anabrid/TeensyLogger/prototype_1.jpg

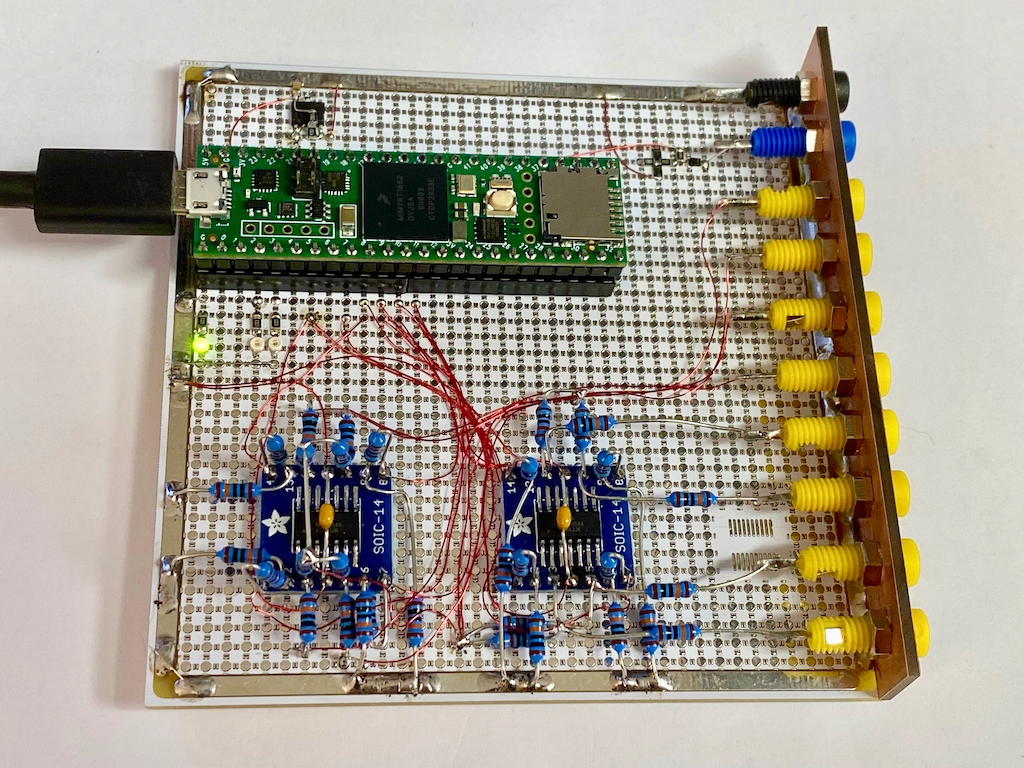
prototype_1.jpg
