anabrid/TeensyLogger/TeensyLogger.pdf

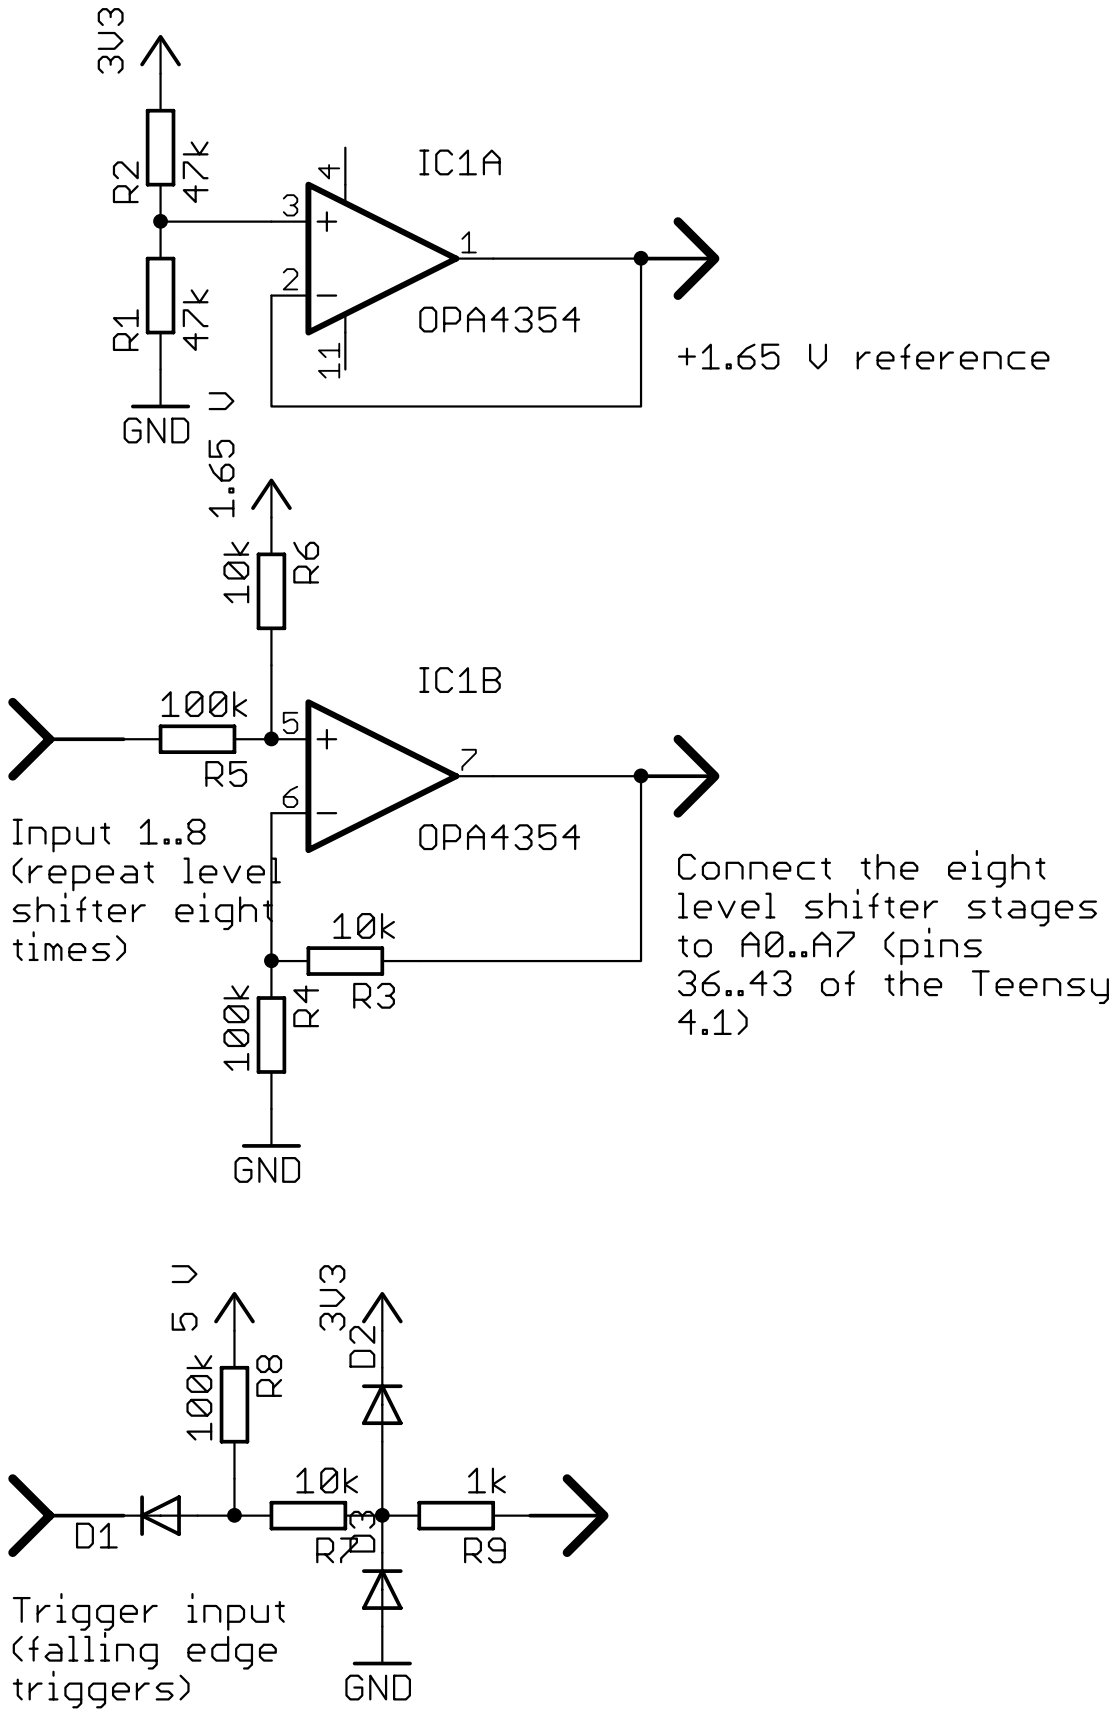
[picture p4: page 1]
