anabrid/TeensyLogger/TeensyLogger.sch

## EAGLE design TeensyLogger.sch (2021-04-13)

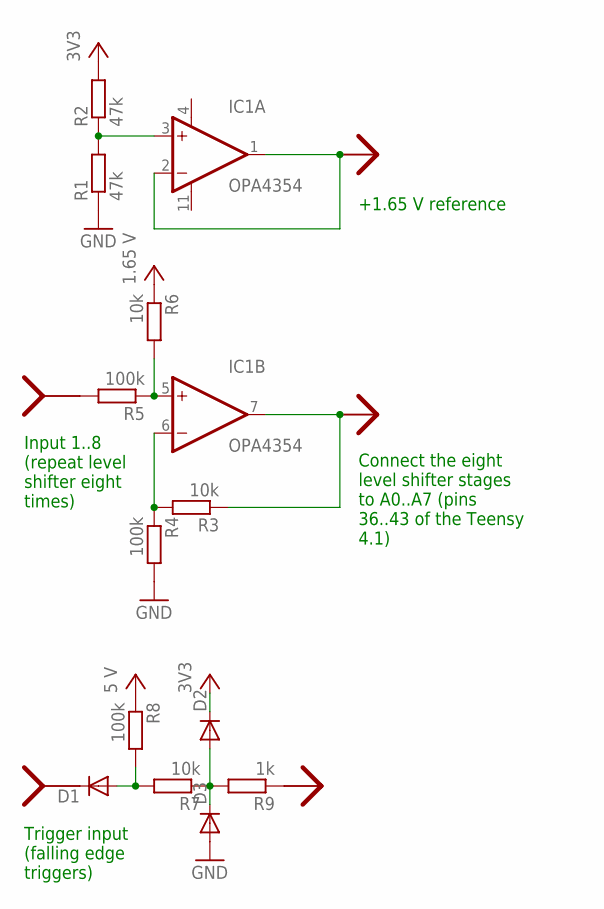
[picture p5: schematic TeensyLogger.sch]

Parts:
D1, D2, D3: 1N4148DO35-7; DO35-7
IC1: OPA4354; SO14
R1, R2: 47k; 0204V
R3, R6, R7: 10k; 0204V
R4, R5, R8: 100k; 0204V
R9: 1k; 0204V
U$1, U$2, U$5: OUTPUT_CONNECTOR_1; ONE_O
U$3, U$4: INPUT_CONNECTOR; ONE_O

Connections:
GND: D3.A, R1.1, R4.2
unnamed: IC1.1 (OUT), IC1.2 (-IN), U$1.P$1
unnamed: IC1.3 (+IN), R1.2, R2.1
unnamed: IC1.6 (-IN), R3.2, R4.1
unnamed: IC1.7 (OUT), R3.1, U$2.P$1
unnamed: IC1.5 (+IN), R5.1, R6.2
unnamed: R5.2, U$3.P$1
unnamed: D1.C, U$4.P$1
unnamed: D1.A, R7.2, R8.2
unnamed: D2.A, D3.C, R7.1, R9.2
unnamed: R9.1, U$5.P$1
VCC: D2.C, R2.2, R6.1, R8.1

Notes on the sheet:
+1.65 V reference
Input 1..8 (repeat level shifter eight times)
Trigger input (falling edge triggers)
Connect the eight level shifter stages to A0..A7 (pins 36..43 of the Teensy 4.1)
