anabrid/TeensyLogger/(commit log)

2021-04-13 Initial commit.
    [TeensyLogger.sch]
2021-07-20 Teensy data aquisition code
    An exemplaric code I wrote several months ago, for data aquisition. I think it worked.
2021-09-17 Changed the output format of the 'dump' command. Data is now written as channel0,channel1,...,channeln;channel0,channel1,...,channeln;... The \n character comes only after all samples are written out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
